cwiskng-max/GNSS_compass/Schematic.pdf

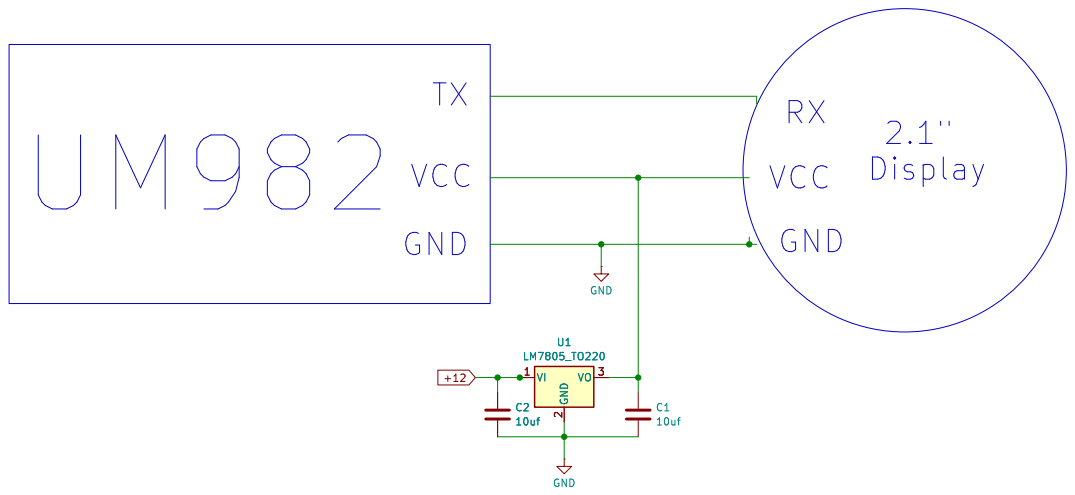
[picture p1: page 1]

Id: 1/1 Title: File: Sheet: / GND
