cwiskng-max/GNSS_compass/(commit log)

2026-07-30 Add Bill of Materials for project components
2026-10-11 Update BOM to specify Hammond 1590A box
2026-10-14 Enhance UI, add ARRL contest distance, and improve input handling
    - Calculate and display ARRL 10 GHz contest distance (spherical Earth R=6371.0 km, 1 km minimum) formatted to 1 decimal place.
    - Synchronize target bearing, reverse bearing, and antenna heading across all update events.
    - Display dashed placeholders on boot for uninitialized antenna heading (---.-) and UTC time (--:--Z).
    - Add 5-second inactivity auto-lock timeout (EDIT_TIMEOUT_MS) with edit mode enabled on boot.
    - Expand touchscreen hit target area to include caret row and surrounding margins with coordinate clamping.
    - Adjust vertical layout to comfortably fit all 6 rows on 480x480 circular display.
    - Robust NMEA $GNGLL stat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
2026-10-14 Integrate Gary's rover move distance check, GNTHS support, and backlight update
    - Tap local grid (Row 1) to copy current Maidenhead grid into target grid.
    - Highlight rover transit distance in RED on WHITE if moved distance is under 16 km (rovdist flag).
    - Support both modern $GNTHS and legacy $GNHDT NMEA heading sentences.
    - Increase backlight PWM brightness to 250.
    - Route I2C init error to USB Serial and echo raw NMEA sentences for debugging.
2026-10-14 Add GitHub Actions workflow for automated firmware builds and rolling releases
    - Automates ESP32-S3 firmware build using arduino-cli on push and pull requests.
    - Uploads compiled gps_compass.ino.esp32s3.bin as a downloadable build artifact.
    - Publishes rolling 'latest' pre-release on branch push for public download without GitHub login.
    - Automatically creates tagged GitHub Releases with attached binary on version tags (v*).
2026-10-14 Add firmware version footer to display and automate CI version injection
    - Define FW_VERSION as 'v0.2-dev' in gps_compass.ino for local builds.
    - Render centered version string in subtle dark grey (0x7BEF) on display footer (Y=444).
    - Print firmware version to USB Serial on boot.
    - Automate CI version injection in build workflow: official version tags (v*) for releases, v0.2-<short-sha> for branch commits.
    - Publish GitHub releases strictly on version tags (v*), eliminating moving latest tags.
    - Remove retired ui-enhancements branch from workflow triggers.
2026-10-14 Update CI actions to eliminate Node.js deprecation warnings and remove prebuilt binary
    - Upgrade actions/checkout from v4 to v7 (Node 24 native)
    - Upgrade actions/upload-artifact from v4 to v7 (Node 24 native)
    - Upgrade softprops/action-gh-release from v2 to v3 (Node 24 native)
    - Retain arduino/setup-arduino-cli at v2
    - Remove obsolete tracked root gps_compass.ino.esp32s3.bin binary
2026-10-14 Eliminate duplicate calcLatLon and unify on calcGridCenter with double precision
    - Remove redundant calcLatLon function.
    - Call calcGridCenter in updateBearings for case-insensitive grid parsing.
    - Upgrade remlatitude and remlongitude to double precision.
2026-10-14 Rename to calcLatLon, simplify grid parsing, and add ENABLE_ARRL_DIST toggle
    - Use calcLatLon function name and index grid directly without case conversion loop.
    - Retain double precision and explicit fractional degree division.
    - Add ENABLE_ARRL_DIST configuration toggle (default 0).
    - Rebalance vertical layout spacing when ARRL contest distance is hidden.
2026-10-14 Add automated C++ unit tests to CI workflow
    - Validate ARRL 1 km minimum distance rule and path symmetry.
    - Validate calcLatLon grid-to-coordinates conversion and calcLocator round-trip.
    - Validate calculateWGS84 geodesic distance and cardinal bearings.
    - Validate string buffer lengths, formatting, and ghost character erasure.
    - Validate rover 16 km transit threshold.
    - Run tests in CI on each push and PR before Arduino compile.
2026-10-15 Add on-device visual self-test with status footer, pass banner, and test documentation
2026-10-15 docs: add firmware build guide using arduino-cli
2026-10-16 docs: refine BOM structure and ratings, update install verification details, and reorder docs
2026-10-24 feat: add color-coded bearing quality states, KSXT support, and GPS stream diagnostics
    - Implement color-coded bearing display: Pure White for RTK Fixed, Bright Yellow for RTK Float, and Bright Red for Lost/Stale
    - Preserve white '---.-' state on boot until initial heading lock is achieved
    - Add 1.5s staleness watchdog to prevent silent display freeze when signal drops
    - Implement dual-protocol parsing for Unicore $KSXT with automatic fallback to legacy $GNHDT and $GNTHS
    - Add GPS stream link diagnostics reporting to Serial Monitor ('status', 'gps', 'help')
    - Integrate live GPS stream check (Test 6) with status card into on-device self-test sequence
    - Add unit tests for token extraction, sen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
2026-10-24 fix: sync time and position via KSXT, reject non-differential bearing on boot, and streamline receiver config
2026-10-26 docs: add mast mounting hardware and fitment tips to BOM, update README and RECEIVER docs
2026-11-04 Add antenna heading calibration with NVS storage and touch UI
    - Add non-volatile antenna alignment offset via ESP-IDF Preferences (NVS)
    - Rebalance Row 3 display layout to create an 80px center slot for the CAL status pill
    - Implement touch-activated calibration modal with Snap to Target, Reset (0.0), and Cancel
    - Connect rotary encoder to fine-tune proposed offset by +-0.1 deg
    - Add 'cal' serial commands (cal, cal snap, cal zero, cal set <float>)
    - Add unit tests for angle normalization, offset application, and wrapping (15/15 passing)
    - Update on-device visual self-test to demo CAL pill states and modal dialog
    - Add docs/design/ documentation architecture and calibration specification
    - Re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
2026-11-04 Update calibration UX: instant modal open and hold-to-save slider
    - Tap on CAL pill immediately opens calibration modal dialog
    - Tap on RESET (0.0) or SNAP TARGET updates display only without flash write
    - Require 1.5s hold on SAVE button with dynamic fill slider to commit to NVS
    - Tap on CANCEL immediately exits without writing to flash
    - Update design documentation to match interaction flow
2026-11-04 Fix background GPS heading and time poke-through during calibration modal
    - Suppress background bearing, time, and locator screen redraws when UI_MODE_CALIBRATING is active
    - Live-update 'Raw GNSS Hdg' line inside the calibration card when heading updates arrive
    - Repaint full main screen cleanly on modal exit via redrawMainScreen
2026-11-04 docs: add retroactive design specifications for core subsystems
    Add formal design documentation in docs/design/ covering implemented
    features and architectural subsystems:
    - visual-self-test: display self-test demo, GpsLinkVerdict state
    machine, and serial diagnostics
    - rover-transit: ARRL <16 km rover proximity alert and 1-tap local
    grid snapshot
    - gnss-heading-pipeline: Unicore KSXT/NMEA dual-antenna RTK heading,
    vector averaging, 1.5s watchdog, and color quality states
    - maidenhead-geodetics: subsquare center geodetics, great-circle
    forward/reverse bearings, ARRL 1.0 km clamp, and native C++ test suite
    - circular-touch-ui: 480x480 circular layout budget, Maidenhead touch
    editor,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
2026-11-04 Enhance calibration card UI with button touch highlights and cobalt blue snap button
2026-11-04 ui: adjust yellow highlight to rich golden amber for sunlight readability
    Standard RGB565 yellow (0xFFE0, R=31, G=63, B=0) easily washes out to
    near-white in direct outdoor sunlight. Because red and green were both
    saturated at 100%, broadband ambient daylight reflection on the display
    glass quickly saturates the eye's color receptors and desaturates the
    hue into white.
    Define and switch to RICH_YELLOW (0xFEA0, ~#FFD400), tuned to aviation
    and highway safety gold standards (FAA/MIL-STD-1472):
    - Red channel: Maintained at maximum output (31 / 100%) for peak luminance
    - Blue channel: Kept at 0 for maximum chromatic distance from white (0xFFFF)
    - Green channel: Reduced slightly from 63 to 53 (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
2026-11-04 serial: add USB CDC on boot, non-blocking line parser, and CRLF formatting
    - Enable CDCOnBoot=cdc in build scripts, CI workflows, and documentation
    so Serial routes to native USB (/dev/ttyACM0) on ESP32-S3.
    - Replace blocking character-peek logic with non-blocking line buffering
    supporting both CR (\r) and LF (\n) to prevent stalls in minicom.
    - Add remote character echoing and visual backspace erase (\b \b) so
    terminal emulators work out-of-the-box with default Local Echo: OFF.
    - Switch Serial.printf and CLI status blocks to CRLF (\r\n) to eliminate
    progressive staircase indentation.
2026-11-04 docs(bom): recommend 4-pin connector for forward compatibility
2026-11-05 docs(bom): add Amazon source link for 4-pin GX12 connector
2026-11-05 docs(bom): add Amazon product links for receiver, display, antennas, and wiring
2026-11-05 docs: add dedicated ESP32 serial interface and CLI guide
2026-11-05 Add more links to amazon on bom
2026-11-07 feat(sim): add host-driven GPS data simulator and rover transit test suite
    - Implement host-driven simulation tool in tools/gps_sim.py supporting:
    * Rover transit journey scenario (evaluating ARRL 16 km legal rule)
    * Mountain canyon switchback / backtrack scenario
    * 360-degree antenna rotator continuous sweep
    * RTK quality degradation & watchdog timeout cycle
    * Interactive terminal drive controller (WASD keyboard control)
    * Custom parameter & raw NMEA/ sentence injection
    - Add unified sentence parser (processGpsSentence) in gps_compass.ino
    - Support 4-, 6-, and 8-digit Maidenhead grids with center-defaulting
    - Add sim CLI commands (sim on/off/hdg/pos/grid/rover/time/status)
    - Iso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
2026-11-07 refactor(geo,parser): extract pure geodesy, bearing filter, and NMEA parser to src/ (Phase 1)
2026-11-07 refactor(config,system,gnss): extract config, calibration, and simulator to src/ (Phase 2)
2026-11-07 refactor(modularization): standardize identifiers, implement missing design specs, and fix edge-case bugs
    - Standardize identifiers in gps_compass.ino and SelfTestContext (targetGrid, myGrid, currentPosition, targetPosition, isRoverAlertActive, cursorColumn) per DESIGN.md §5.2 and §2.1
    - Implement normalizeHeading in src/geo/geo_math.* per DESIGN.md §4.2
    - Add parseHdtHeading and parseThsHeading wrappers in src/protocol/nmea_parser.h per DESIGN.md §4.3
    - Add scoped enum aliases (None, Fixed, Float, Lost, Disconnected, etc.) in src/types.h per DESIGN.md §4.1
    - Fix unsigned subtraction underflow in GpsManager::evaluateStreamHealth when called with default nowMs=0
    - Clamp Haversine accumul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
2026-11-07 fix(firmware): resolve concurrency races, buffer bounds, and rollover issues
    - Protect encoder ISR and atomic counter extraction with critical sections
    - Accumulate encoder steps in ISR and preserve multi-step queueing
    - Add length and token boundary checks in parseLegacyLatLon and gridToGeoPoint
    - Fix 32-bit millis() rollover logic in heading staleness watchdog
    - Replace blocking delay(120) modal button flashes with non-blocking timer
    - Decouple PCF8574 expander to support encoder pushbutton reading on P5
    - Move 1KB feed buffer from stack to BSS member in GpsManager
    - Add unit test coverage for parser safety, rollover, and encoder switch
2026-11-07 refactor(modularization): extract Board, GridEditor, AppController and decouple SerialCli
2026-11-07 fix(review): preserve rover physical coordinates, fix rollover timer, bounds, and add TX support
    - Preserve true 64-bit physical coordinates in AppController::updateBearings during rover transit mode, eliminating Maidenhead grid-center quantization error
    - Ensure 32-bit millis() rollover safety for modal button release timer in AppController
    - Add bounds check on legacy $GNGLL/$GPGLL sentence parsing via getNthField to avoid out-of-bounds reads
    - Implement GpsManager::sendCommand, GpsManager::sendBytes, and GpsTxCallback for upcoming bidirectional TX line
    - Disarm rover alert on target character touch per specification
    - Synchronize target grid to local grid during 'sim rover' when origin is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
2026-11-07 refactor(system): decouple geodesy calculation from navigation row rendering
    - Replace legacy updateBearings with decoupled methods:
    - recalculateGeodesy(): pure domain model geodesy math (distance, forward/reverse bearing)
    - renderNavigationRows(): pure view presentation (Rows 3, 4, 5) with modal suppression
    - updateNavigation(): unified coordinator invoking recalculateGeodesy followed by renderNavigationRows
    - Update AppController event handlers, GPS callbacks, and SelfTest to use updateNavigation
    - Add unit test asserting independent execution of model geodesy and view rendering
2026-11-07 fix(rover): auto-exit edit mode on rover snapshot to protect origin grid and bezel
    - Automatically set gridEditor_.setEditing(false) when snapshotting local summit origin
    - Hide cursor to prevent accidental bezel turns and road vibration bumps from mutating the origin grid
    - Ensure rover transit mode remains armed against inadvertent knob rotations
    - Re-arm editing and disarm rover alert only upon explicit touch on Row 2 (Target Grid)
    - Update design documentation and unit test suite with regression verification
2026-11-08 refactor(arch): standardize inlining vs encapsulation boundaries
    - Move AppController::setHeadingState out-of-line into app_controller.cpp to encapsulate branch logic
    - Move SerialCli::getNavContext and dependent getters out-of-line into serial_cli.cpp to prevent call-site struct-copy overhead
    - Inline trivial single-statement forwarder Calibration::commitProposed in calibration.h
    - Replace aton(x) macro in config.h with type-safe single-evaluation inline charToDigit
    - Add unit tests for charToDigit conversion and setHeadingState lifecycle
2026-11-08 feat(ui,geo): use ARRL contest distance for reverse bearing and hide Row 6 by default
2026-11-08 docs(design): add rover mode, transit tracking, history and geodesics specification
    - Formalize dual operational states: Bearing Mode vs. Rover Mode
    - Specify dynamic 16 km displacement tracking using WGS-84 point-to-point geodesics
    - Define Maidenhead grid boundary traversal check and reversible backtrack handling
    - Require rotary encoder physical push-button click to confirm arrival / exit Rover Mode
    - Design persistent multi-stop contest location history with 'Discard Last Stop' auto-rearm
    - Specify decoupling of geodetics into a modular engine (Geodesics.h / Geodesics.cpp)
2026-11-08 docs(design): refine rover mode states, 0.1km resolution, and embed visual previews
    - Update myGrid terminology throughout specification
    - Clarify 16 km displacement rule vs 6-char grid geometry (max 8.6 km diagonal)
    - Document visited grid history purpose: avoiding duplicate QSOs across bands
    - Establish 4-state visual qualification matrix on white background cards
    - Specify mandatory continuous 0.1 km decimal precision (%5.1f k)
    - Explore left-slot allocation: Back-Azimuth vs. explicit status words (TRANSIT, QUAL, REVISIT, NO GPS)
    - Embed SVG on-screen preview graphics ensuring white card fidelity across dark/light themes
    - Document integration with adopted modular geodesics under src/geo/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
2026-11-08 docs(design): refine rover mode specification and visual qualification cards
    - Display last known valid displacement and bearing in State 4 (Deep Amber on White) when GPS fix is lost or stale
    - Make MAX_ROVER_STOPS a non-volatile NVS config setting in 'rover_cfg' defaulting to 100 (range 10-500)
    - Add 'rover max [n]' serial CLI command for capacity configuration
    - Synchronize Sections 5, 6, and 7 with the streamlined Row 5 white card UI budget
    - Clarify Row 6 suppression during Rover Mode to focus driver attention on qualification
    - Align gps_sim.py test commands and unit test matrix with the 4-state qualification model
    - Remove obsolete multi-banner advisory badge references in favor of Sta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
2026-11-08 docs(design): specify one-shot rover history undo modal and long-press trigger
    - Define 1.5-second long-press on Row 1 (My Grid) to open the Rover History modal
    - Specify foolproof one-shot modal UX with [ DISCARD LAST STOP ] (Red) and [ CANCEL ] (Gray)
    - Auto-close dialog and immediately re-arm Rover Mode on discard
    - Document sequential discard via repeated long-press for multi-stop undo edge cases
2026-11-08 docs(design): add rover history serial command and clarify rover clear scope
    - Add 'rover history' (and alias 'rover log') command to dump full rover stops table over USB serial
    - Clarify in Section 3.1 that serial CLI provides full history viewing since circular UI is optimized for driving metrics
    - Add example ASCII output format for 'rover history'
    - Clarify 'rover clear' resets only rover location history in NVS without affecting calibration or target presets
2026-11-08 docs(design): update layout geometry to 5-row screen budget following PR #12
    - Eliminate Row 6 from Bearing and Rover mode layout specifications
    - Rebalance Row 5 coordinates to Y=376 and update card dimensions (W=400, H=44)
    - Synchronize rendering pipeline documentation with 5-row architecture
2026-11-09 feat(rover): implement Phase 3 app coordination, gestures, and history modal
    - Add OperationalMode (Bearing vs Rover) state machine to AppController
    - Implement 1-tap origin capture with automatic Stop #1 logging
    - Implement 2-step natural target exit (touch character + bezel rotation)
    - Add 5-second edit inactivity auto-lock preserving Rover Mode
    - Implement RoverHistoryModal with Discard Last Stop and auto-rearm
    - Add 1.5-second long-press detection on Row 1 (My Grid)
    - Remove legacy isRoverAlertActive flag in favor of OperationalMode
    - Scale Rover Card geometry to fit 480x480 circular screen chord (Size 3, W=320)
    - Add 4 new test suites (38/38 unit tests passing)
2026-11-09 fix(rover): resolve critical NVS wipeout, stationary GPS watchdog, modal corruption, and struct packing
    - Prevent NVS contest history data loss: replace logPrefs.clear() in
    RoverLogManager::saveToNvs() with in-place key overwrite and selective
    trailing key cleanup. If a power cut or vehicle ignition drop occurs
    mid-write, existing valid contest stops remain preserved in flash.
    - Fix false-alarm State D (NO GPS) watchdog on stationary vehicles:
    remove the 0.00001 deg positional delta suppression gate from
    GpsManager::processSentence() so valid 5 Hz $KSXT fixes keep the
    staleness timer fresh. Add text caching / dirty-checking in
    DisplayUi::renderRoverCard() and AppController::set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
2026-11-09 fix(rover): resolve high priority geodetic, boundary, and state machine edge cases
    - Prevent false origin snapshot at (0, 0): guard AppController::startRoverMode()
    and SerialCli::handleRoverStart() with a strict hasLocation check. Attempting
    to arm Rover Mode without an active GPS fix is rejected and triggers a
    'WAIT GPS FIX' warning rather than latching (0, 0).
    - Eliminate 15.96 km boundary rounding deception: floor-truncate displacement
    in RoverCard::formatRoverCard() to the nearest completed 0.1 km
    (std::floor(km * 10.0) / 10.0). Sub-16.0 km moves (e.g. 15.96 km) display
    as '15.9 k' and only transition to '16.0 k' once legally qualified.
    - Enforce 2-step natural target exit on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
2026-11-09 fix(rover): resolve medium & low review findings (epoch timestamps, chord fit, touch bounds)
    - Finding 12 (Midnight timestamp rollover with $KSXT-only streams):
    - Extracted full 14-digit UTC date/time (YYYYMMDDhhmmss) from Field 1 of $KSXT
    - Implemented portable, deterministic utcCalendarToEpoch() to calculate 32-bit UNIX epoch seconds
    - Integrated epoch timestamp into GpsManager and populated RoverStop::timestamp with true epoch seconds, eliminating 24h midnight rollover without requiring extra NMEA streams
    - Finding 10 (Circular screen chord clipping & ghost text in Row 5):
    - Scaled REVBEAR_SZ to Size 3 (centered at REVBEAR_X=105) so Bearing Mode reverse bearing & distance text fit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
2026-11-09 fix(gnss): guarantee full backward compatibility for legacy $G messages and compact $KSXT
    - Legacy $G Message Support ($GPHDT / $GNHDT / $GPTHS / $GNTHS + $GPGLL / $GNGLL):
    - Retained complete dual-stream parsing for legacy receivers configured per RECEIVER.md
    - Heading defaults to BEARING_FIXED (White) since legacy HDT lacks RTK quality fields
    - Signal loss (empty HDT or > 1.5s timeout) transitions cleanly to BEARING_LOST (Red)
    - Lat/Lon and UTC time from GLL properly arm and qualify Rover Mode (State A -> B)
    - Compact / Legacy $KSXT without Quality Tokens:
    - Added fallback in parseKSXT() when field 11 is absent (treats valid heading as FIXED)
    - Added fallback in parseKSXTLocati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
2026-11-09 fix(ui): use crisp white text on rover history discard button
    - Changed RoverHistoryModal::drawDiscardButton() foreground from RED to WHITE on BUTTON_RESET_BG (dark red)
    - Updated border to turn WHITE on touch highlight, aligning with CalibrationModal::drawResetButton()
2026-11-09 rover: require long-press on discard button with red progress and fix post-delete card staleness
    - Require 1.5s long-press hold on Rover History Discard button (mirroring CalModal Save button behavior) to guard against accidental touches
    - Render expanding progress bar in complementary red (RED 0xF800 fill over BUTTON_DISCARD_HOLD_BG 0x6000 and BUTTON_DISCARD_IDLE_BG 0x4000)
    - Invalidate displayUi dirty-check cache (lastRoverCardState_ and lastRoverCardBuf_) in clearScreen() and redrawMainScreen() so Row 5 rover card is never omitted after screen wipes
    - Explicitly evaluate GPS fix freshness upon modal exit and during Rover Mode: if GPS fix is absent or stale (>3000 ms), format Row 5 as 'NO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
2026-11-09 feat(sim): add accelerated rover first-transit scenario and bash runners
    - Add 'first-transit' scenario to tools/gps_sim.py:
    * Clears contest history in NVS (clean slate)
    * Injects Stop #1 origin coordinates and stops transmit to test 'NO GPS' tolerance
    * Prompts user to arm Rover Mode on touchscreen (or over serial CLI)
    * Simulates accelerated 3-phase journey (< 1 min total):
    Phase 1: Approach 15.2 km -> 16.8 km (crosses 16 km: Red TRANSIT -> Green QUALIFIED)
    Phase 2: Canyon Backtrack 16.8 km -> 14.8 km (drops under 16 km: Green -> Red TRANSIT)
    Phase 3: Ridge Breakout 14.8 km -> 17.0 km (re-crosses 16 km: Red -> Green QUALIFIED)
    * Holds final qualified state for 8 seco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
2026-11-09 feat(sim): add duplicate grid square and revisit simulation scenario
    - Add 'duplicate-grid' subcommand to tools/gps_sim.py:
    * Seeds 3-stop contest history with 2.5s visual pauses on each state
    * Arms Leg 4 from Stop #3 (CM97ee)
    * Demonstrates full state transitions:
    - Phase 1: Transit (< 16 km, Red) -> Qualified in fresh grid (Green)
    - Phase 2: High-speed jump to 43.5 km outside duplicate grid CM87wa
    - Phase 3: Moves across boundary into duplicate grid CM87wa -> REVISIT (Royal Blue)
    - Phase 4: Moves back out into fresh grid CM87xa -> QUALIFIED (Green)
    - Phase 5: Stops Rover Mode and commits Stop #4 to history log
    - Add tools/run_rover_duplicate_grid.sh runner script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
2026-11-09 feat(test): add rover onboard self-tests and fix gps stream diagnostic timeout
    - Re-enumerate visual test stages from 7 to 9 with 1-to-1 matching mathematical/logic invariant assertions
    - Add cooperative non-blocking GPS polling to eliminate false GPS link disconnection timeouts
    - Suppress UI callbacks during self-test via AppController::isSelfTesting()
    - Add Stage 8 onboard self-test for 4-state Rover qualification card (Transit, Qualified, Revisit, GPS Lost)
    - Add Stage 9 onboard self-test for Rover contest history modal dialog and discard long-press animation
    - Add host-callable SelfTest::runAssertions() and host unit test coverage
    - Update design specification documentation for visual se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
2026-11-09 feat(ble): add wireless Nordic UART serial CLI and BLE status indicator
    - Implement BleSerialManager supporting Nordic UART Service (NUS)
    with asynchronous RX ring buffer and dynamic 240-byte MTU chunking.
    - Integrate dual-transport routing in SerialCli with local echo, line
    buffering, and USB CDC live mirroring.
    - Configure fast advertising intervals (20-40 ms) and connection
    parameters (7.5-20 ms) for instant discovery and low-latency interaction.
    - Add BLE connection indicator glyph on top status bar in DisplayUi.
    - Add structured 9-phase self-test summary and broadcast test/sim outputs.
    - Author technical design document in docs/design/bluetooth-serial/DESIGN.md
    and update SERIAL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
2026-11-10 feat(gnss): implement TX discovery probe state machine and response parser (Phase 1)
    - Add GpsTxState enum and tracking in GpsManager
    - Implement probeTx() with non-blocking timeout and retry logic
    - Add Unicore command response parser for <OK, #VERSIONA, and
    - Add response callback infrastructure for downstream configuration pipelines
    - Add comprehensive unit tests covering all TX discovery probe state transitions
    - Add technical design specification in docs/design/gps-tx-configuration/DESIGN.md
2026-11-10 feat(cli): add GNSS TX discovery, configuration commands, and status diagnostics (Phase 3)
    - Add 'gps probe' command to manually discover TX connection
    - Add 'gps config' and 'gps config baseline <cm> [tol_cm]' commands to run in-system setup
    - Add 'gps send <cmd>' to transmit raw Unicore commands with response echoing
    - Add 'gps check' / 'gps audit' to query receiver runtime parameters
    - Gate transmission-dependent features when TX wire is unavailable
    - Enhance 'status' / 'gps' diagnostic report with bidirectional link, TX capability, and config health
    - Mirror configuration pipeline progress and receiver responses across USB CDC and BLE UART
    - Update SERIAL.md, RECEIVER.md, and tests/READM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
2026-11-10 fix(ble, gnss): defer BLE conn param updates and add real-time probe feedback
    - Defer BLE connection parameter updates to prevent initial GATT discovery collisions (GATT 133 on Android / GATT disconnect on Windows)
    - Add GpsProbeCallback infrastructure reporting probe retry progress and timeout verdicts in real time to the CLI broadcast stream
    - Expand test suite to assert probe retry, timeout, and acknowledgment callback delivery
2026-11-10 fix(ble): resolve Windows and Android connection stability and GATT discovery drops
    - Split BLE advertising into separate 27-byte advData and 19-byte scanResponseData to avoid 31-byte legacy BLE buffer overflow (ESP_ERR_INVALID_ARG)
    - Set Windows 10/11 WinRT-compliant 15.0-30.0 ms slave connection interval hints (AD type 0x12)
    - Gate TX notifications until client CCCD (BLE2902) subscription to prevent service discovery collisions
    - Defer connection callbacks to main loop to keep Bluetooth FreeRTOS task non-blocking (safe for SPI LCD UI updates)
    - Restart advertising immediately on disconnect in BleServerCallbackHandler
    - Update unit tests for subscription state and BLE lifecycle assertions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
2026-11-10 fix(ble): single advertising restart, GAP disconnect, watchdog, and opt-in diagnostics
    - Restart advertising exactly once on disconnect (removed duplicate 100 ms restart)
    - Track advertising state from GAP ADV_START/ADV_STOP events; update() watchdog
    restarts advertising if disconnected and not advertising for 2 s
    - Fix watchdog race by stamping the restart time before clearing state on disconnect
    - 'exit'/'disconnect' now terminates the link via esp_ble_gap_disconnect(peer)
    instead of esp_ble_gatts_close() (which left the ACL up until an idle timer)
    - Lock-free BTC-task -> main-loop event queue so USB Serial logging never blocks
    the Bluetooth stack
    - Always log connect, disconnect (wi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
2026-11-10 refactor(ble): non-blocking TX queue, thread-safety fixes, and transport split
    Bugs
    - Print the BLE device name after app.begin() so the boot banner shows the
    MAC-derived name
    - Record the negotiated MTU from ESP_GATTS_MTU_EVT so 'ble' status is correct
    immediately (dropped the per-write getPeerMTU() lookup)
    - The Bluetooth task no longer writes rxTail_; it records the session boundary
    on connect and the main loop skips stale RX bytes
    Thread safety
    - Shared flags, MTU and connection id are std::atomic; a session counter
    replaces the pendingConnCb_ flag (connection callback is state-based and
    documented as intentionally lossy)
    - Subscription state comes from the CCCD write callback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
2026-11-10 docs(hardware): document GX12 display-receiver connector pinout
    Add BOM.md section 3 with the recommended 4-pin GX12 pinout (GND, TX, RX, 5V), ESP32/UM982 signal mapping, and mating-face diagram. Link it from README.md and RECEIVER.md.
2026-11-10 feat(cli, gnss): auto-probe TX link, trim commands, audit baseline, and add prompt
    - Automatically trigger GNSS TX discovery probe on initial stream detection and reconnect
    - On-demand probe and query queueing for 'gps check'
    - Update audit queries to use supported Unicore commands (VERSION, MODE, UNILOGLIST, HEADINGSTATUSA for baseline)
    - Trim leading and trailing whitespace on serial/BLE commands
    - Add interactive '> ' prompt on boot, empty Enter, and command completion
2026-11-11 feat(cli): add restart/reboot command, bare Enter prompt, and Ctrl+C line cancel
    - Add 'restart' and 'reboot' commands via Board::restart() with 100 ms grace delay
    - Stateful CR/LF tracking in LineBuffer allowing bare Enter to refresh prompt
    - Add Ctrl+C (ETX) and Ctrl+U (NAK) line cancellation in LineBuffer and SerialCli
    - Drain residual bytes from hardware Serial RX buffer on SerialCli boot
    - Update startup banner in gps_compass.ino to include 'gps' and 'help'
    - Document restart/reboot in SERIAL.md Section 3.9
    - Expand test coverage in test_calculations.cpp (50/50 tests passing)
2026-11-11 fix(cli): auto-probe on gps config and prevent premature audit completion
    - Eliminate premature silence timeout in SerialCli::update() that cut off
    gps check before delayed #HEADINGSTATUSA arrived during RTK cycles
    - Auto-probe GPIO 43 TX connection on 'gps config' when TX state is Unknown
    (e.g., after factory reset FRESET or boot silence)
    - Add 'version' and 'ver' commands and compile timestamps in startup banner
    - Inject Git short hash into scratch build config in build/simple_build.sh
    - Document version command in SERIAL.md Section 3.10
2026-11-12 feat(ble): add configurable device name suffix with NVS persistence
